jamesbates/jcpu/schematics/control_logic.pdf

# CLK

+5V

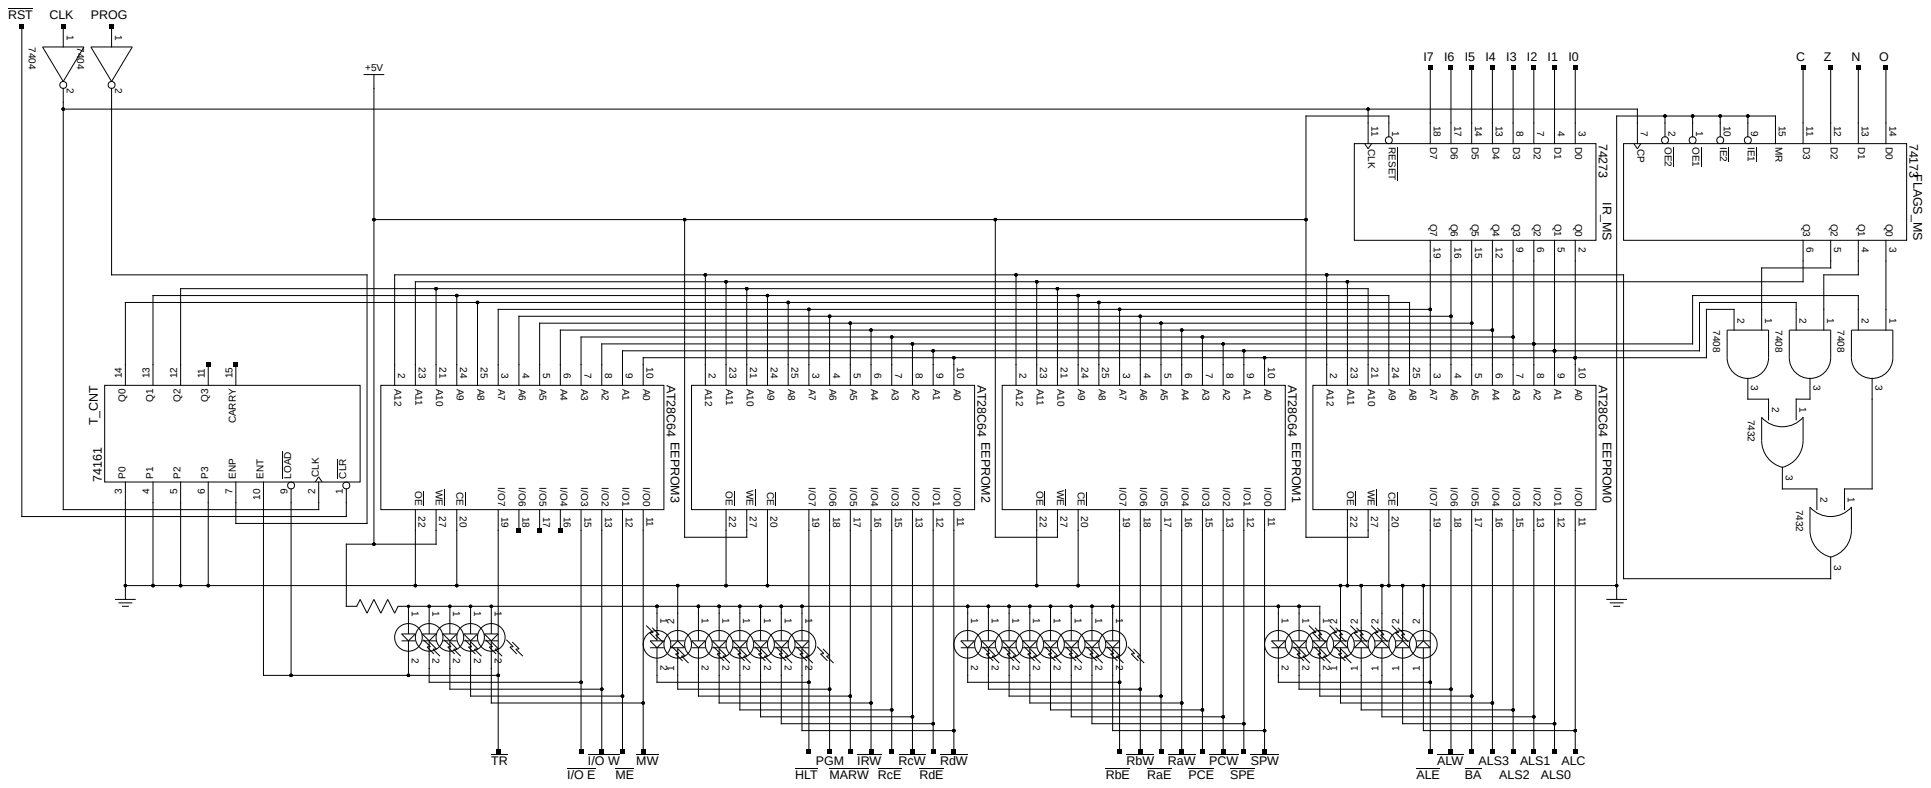
[picture p2: page 1]
