jamesbates/jcpu/schematics/IO.pdf

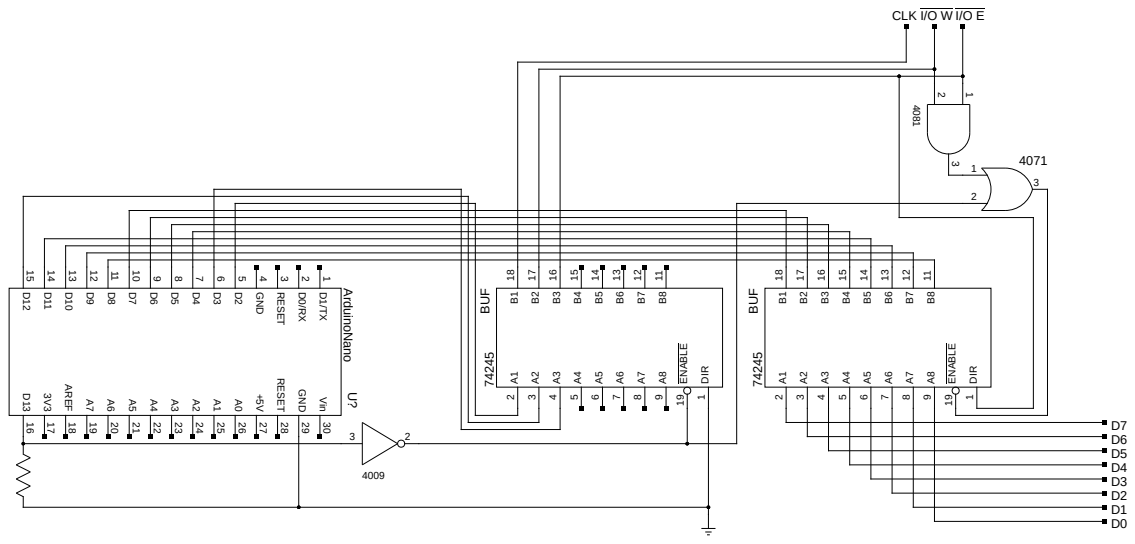
[picture p3: page 1]
