jamesbates/jcpu/schematics/Arduino_programmer.pdf

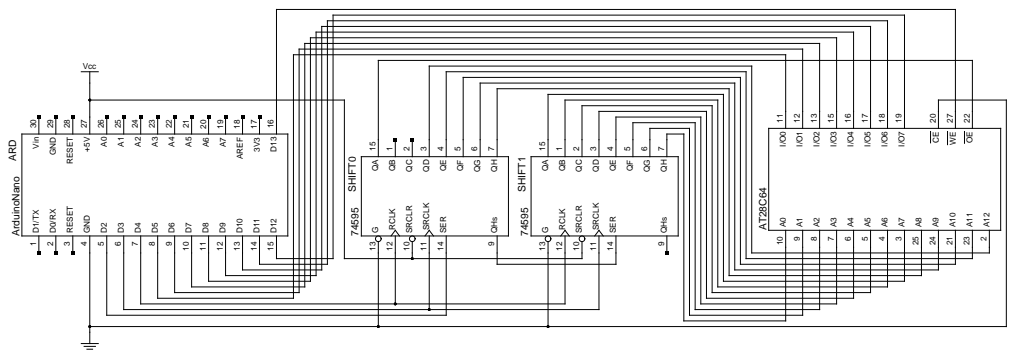
[picture p4: page 1]
