jamesbates/jcpu/schematics/decimal_display.pdf

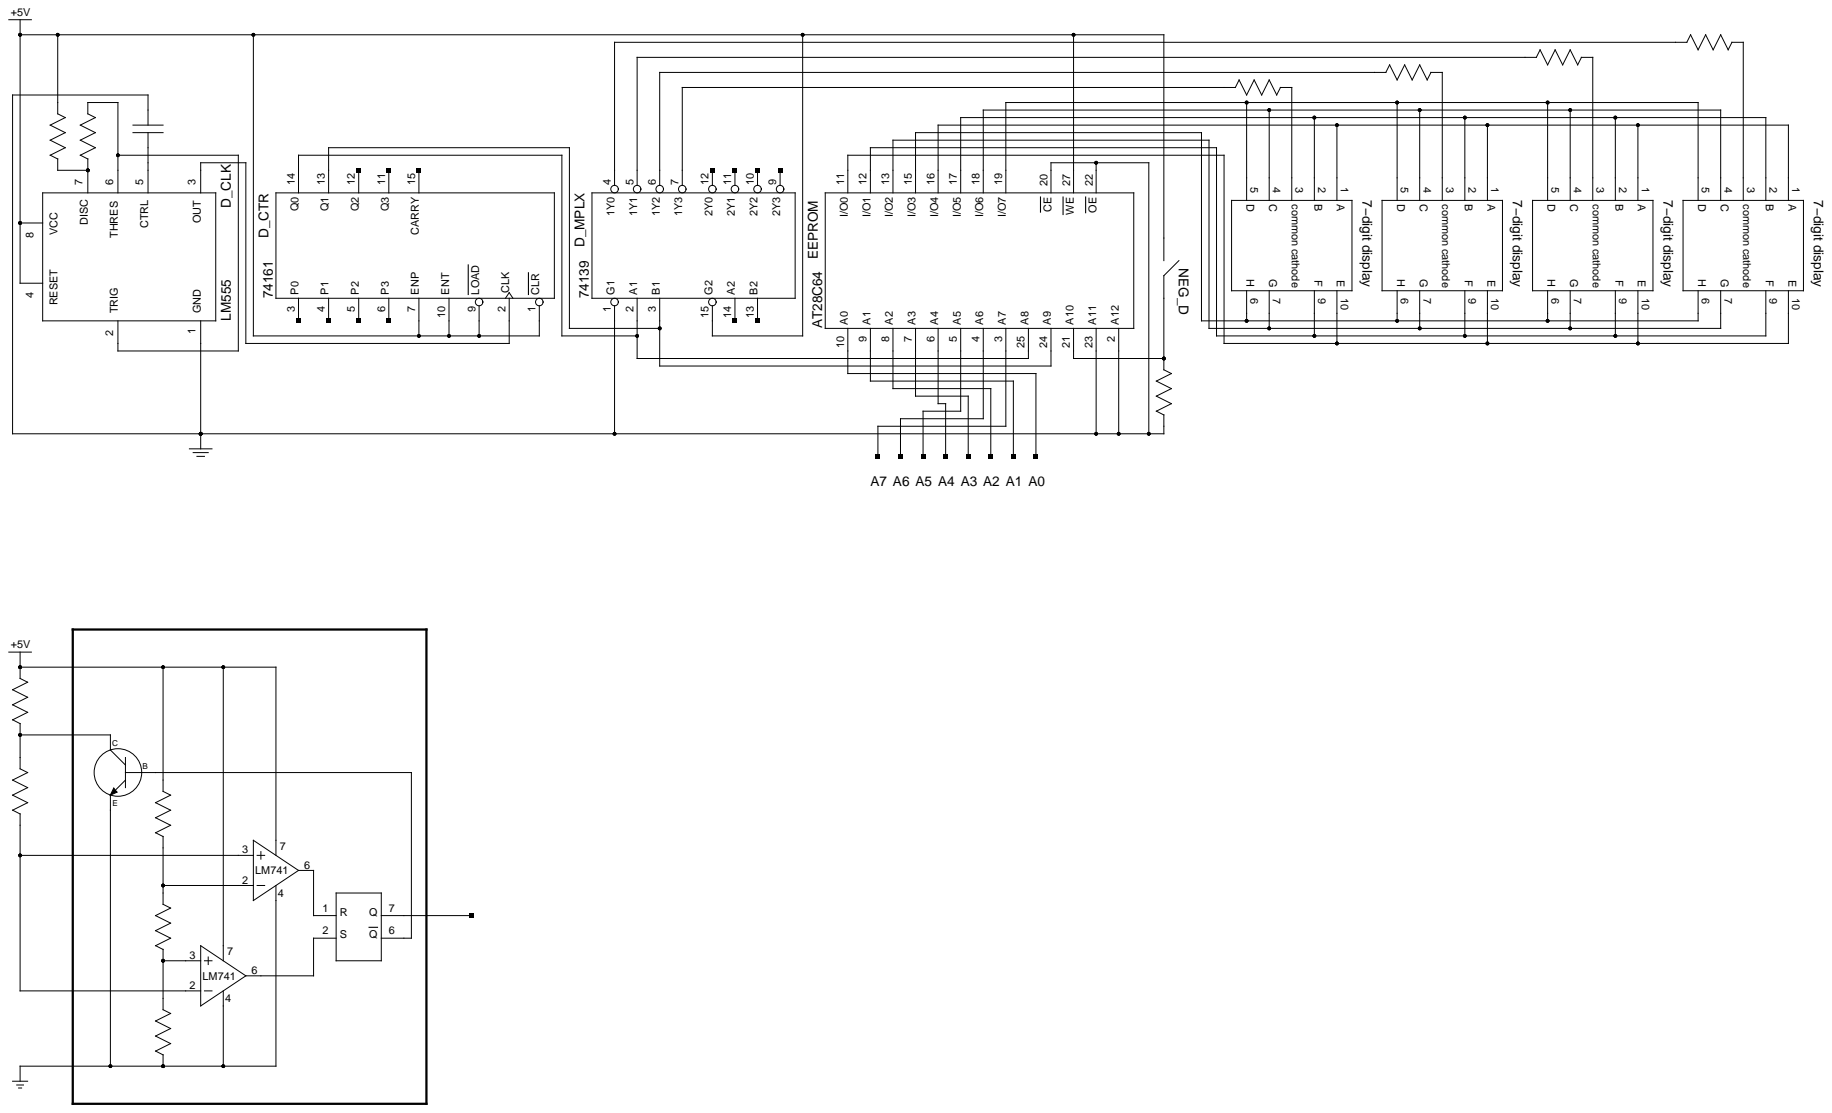
[picture p5: page 1]
