jamesbates/jcpu/schematics/ALU.pdf

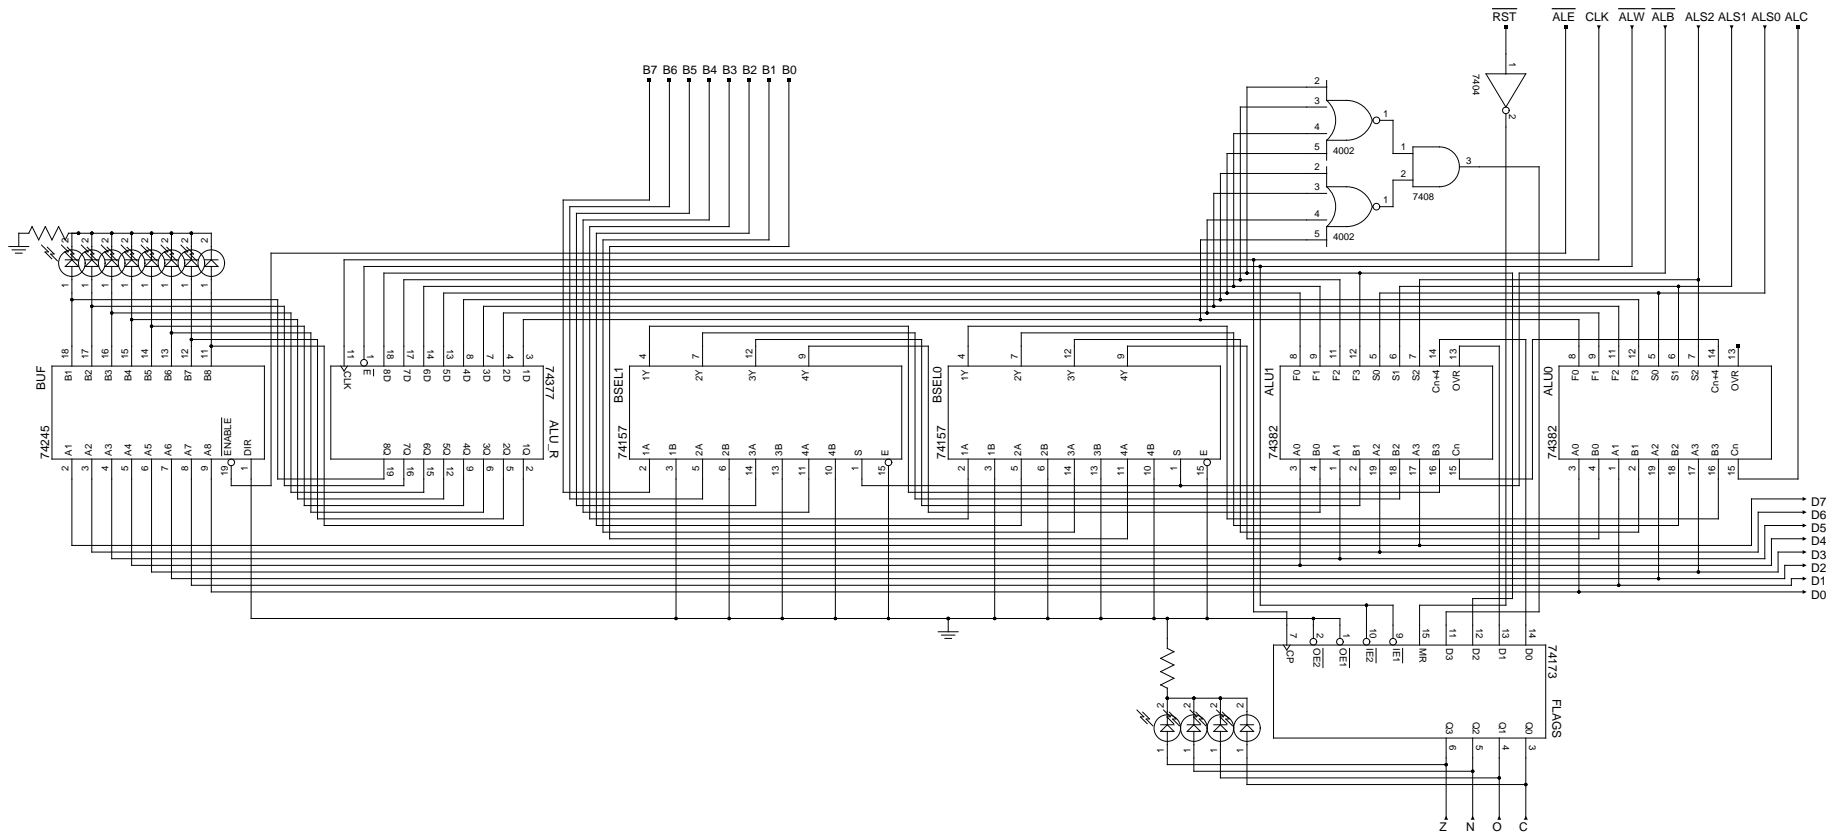
[picture p6: page 1]
