jamesbates/jcpu/schematics/RAM.pdf

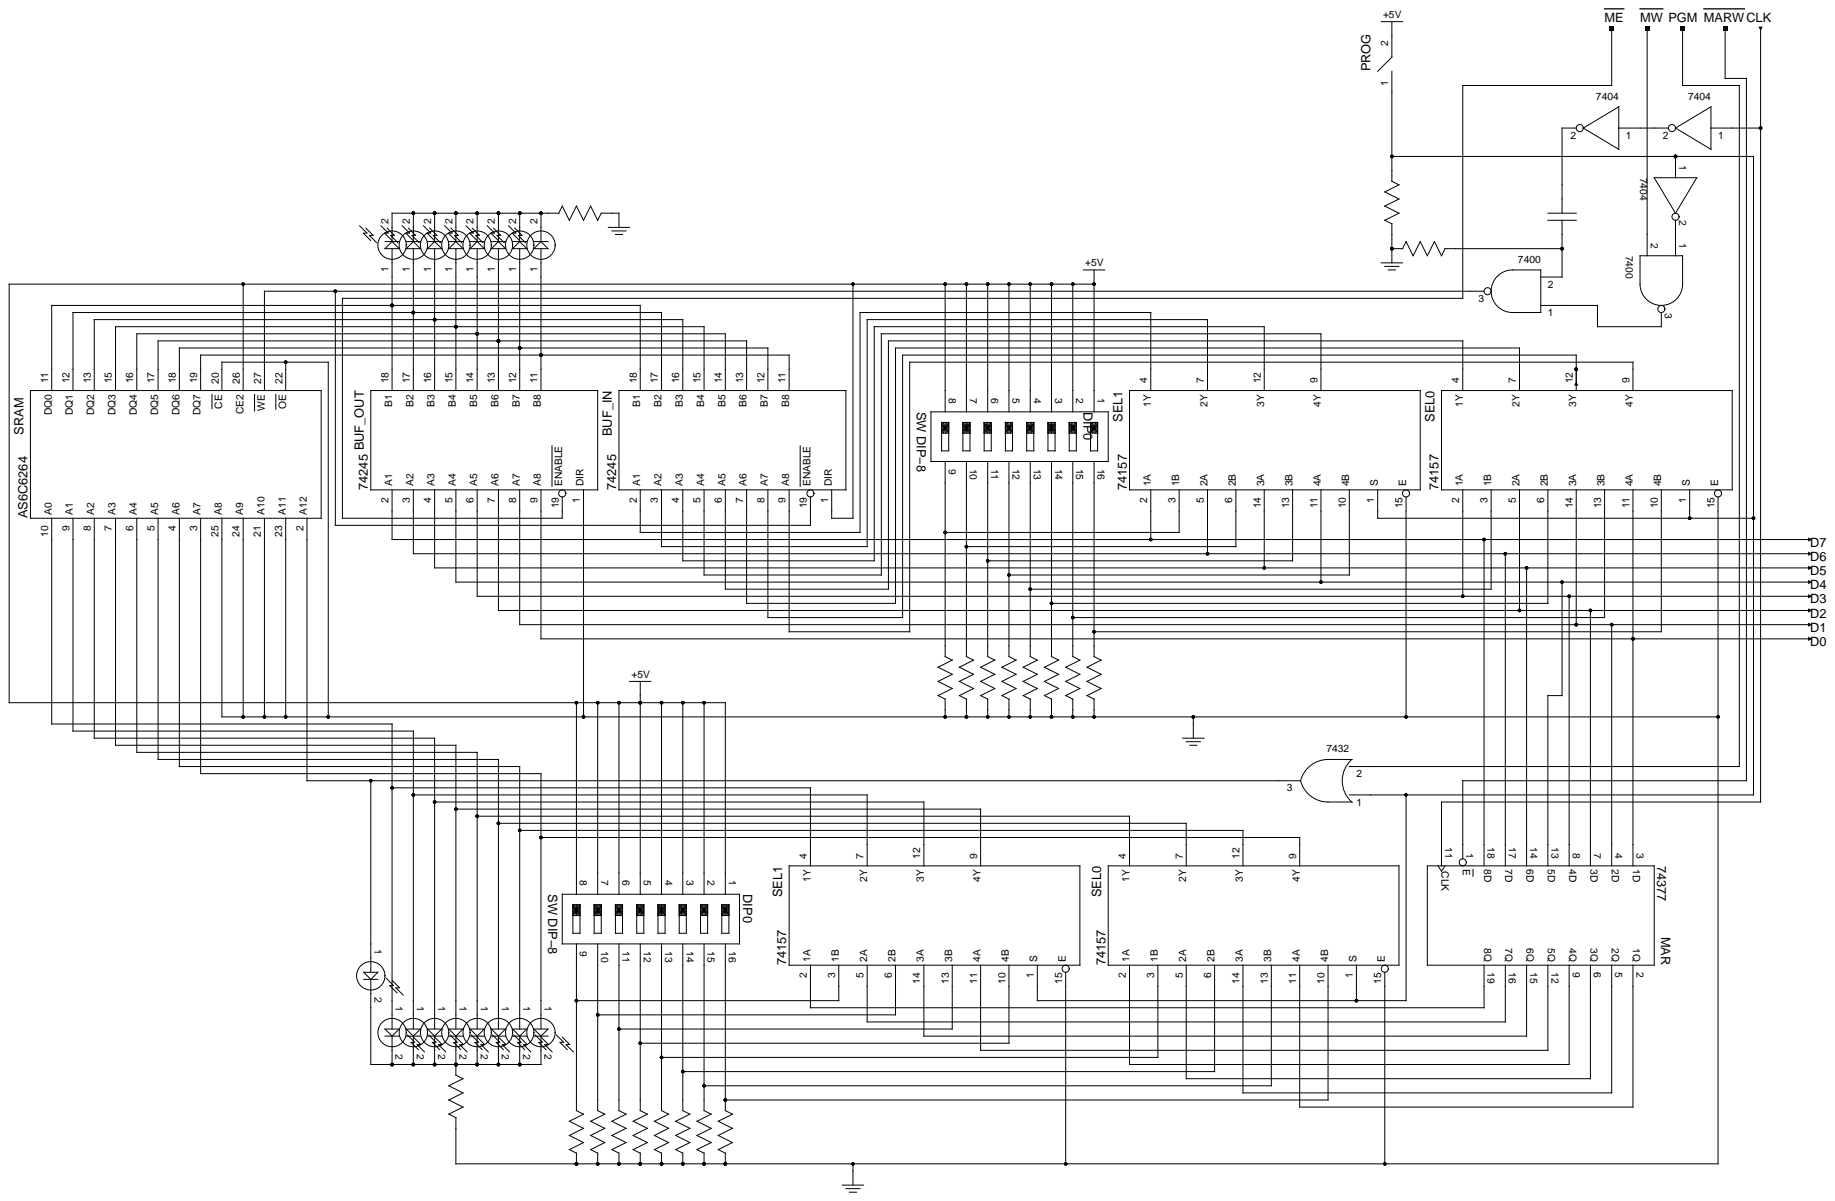
[picture p7: page 1]
