jamesbates/jcpu/schematics/instruction_register.pdf

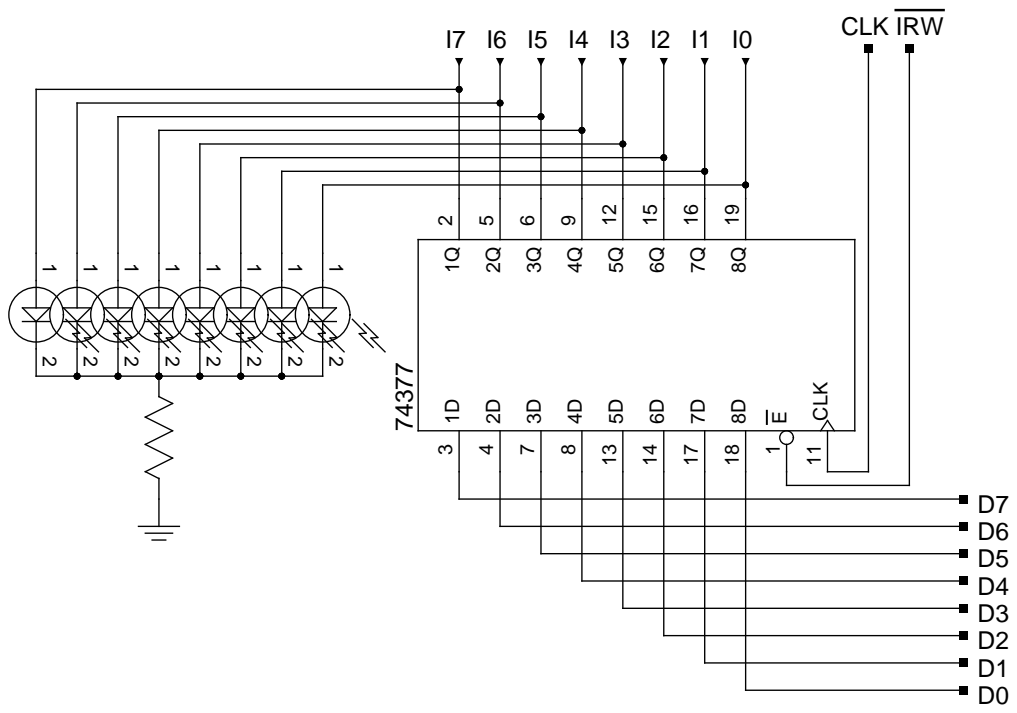
[picture p8: page 1]
