jamesbates/jcpu/schematics/clock.pdf

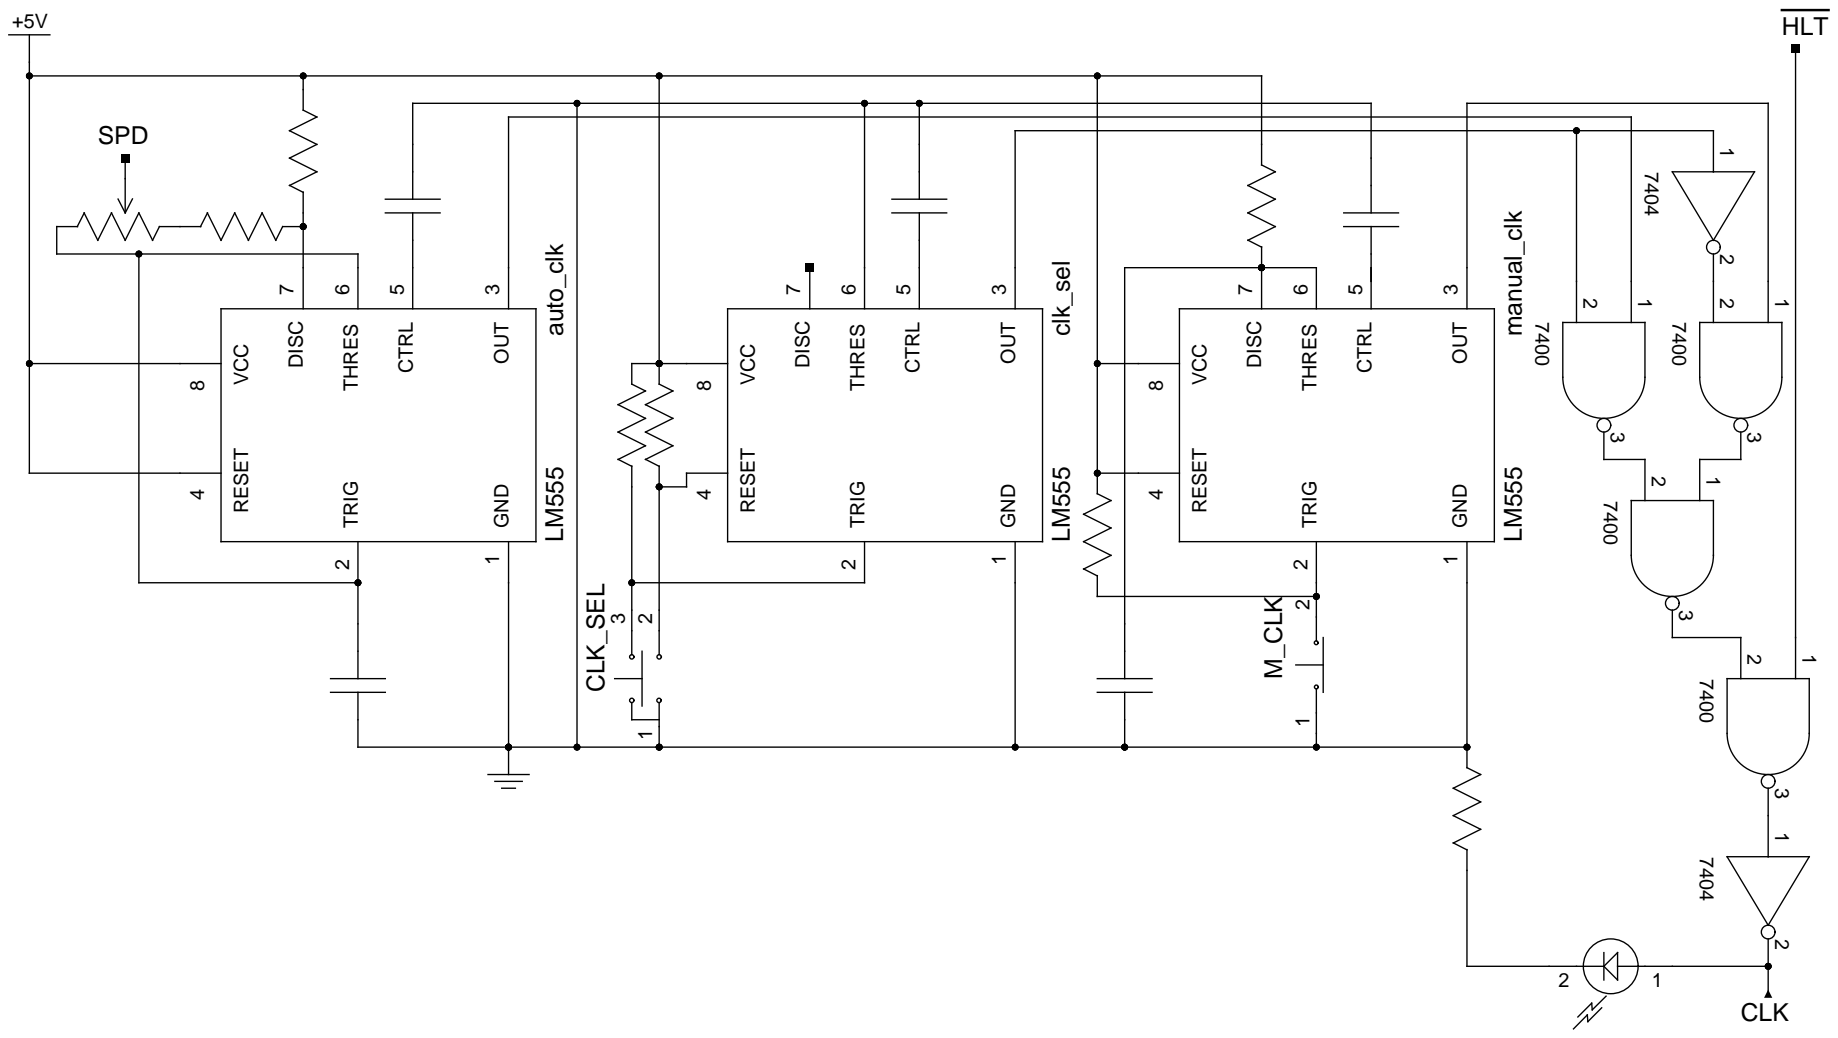
[picture p9: page 1]
RESET VCC; LM555 auto_clk; LM555 manual_clk; LM555 clk_sel
