jamesbates/jcpu/schematics/power.pdf

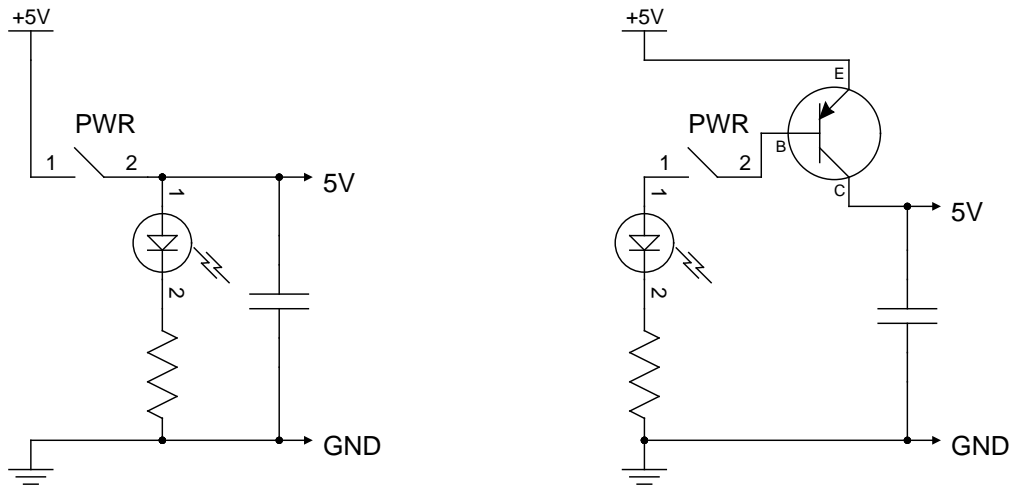
[picture p10: page 1]
