jamesbates/jcpu/schematics/program_counter.pdf

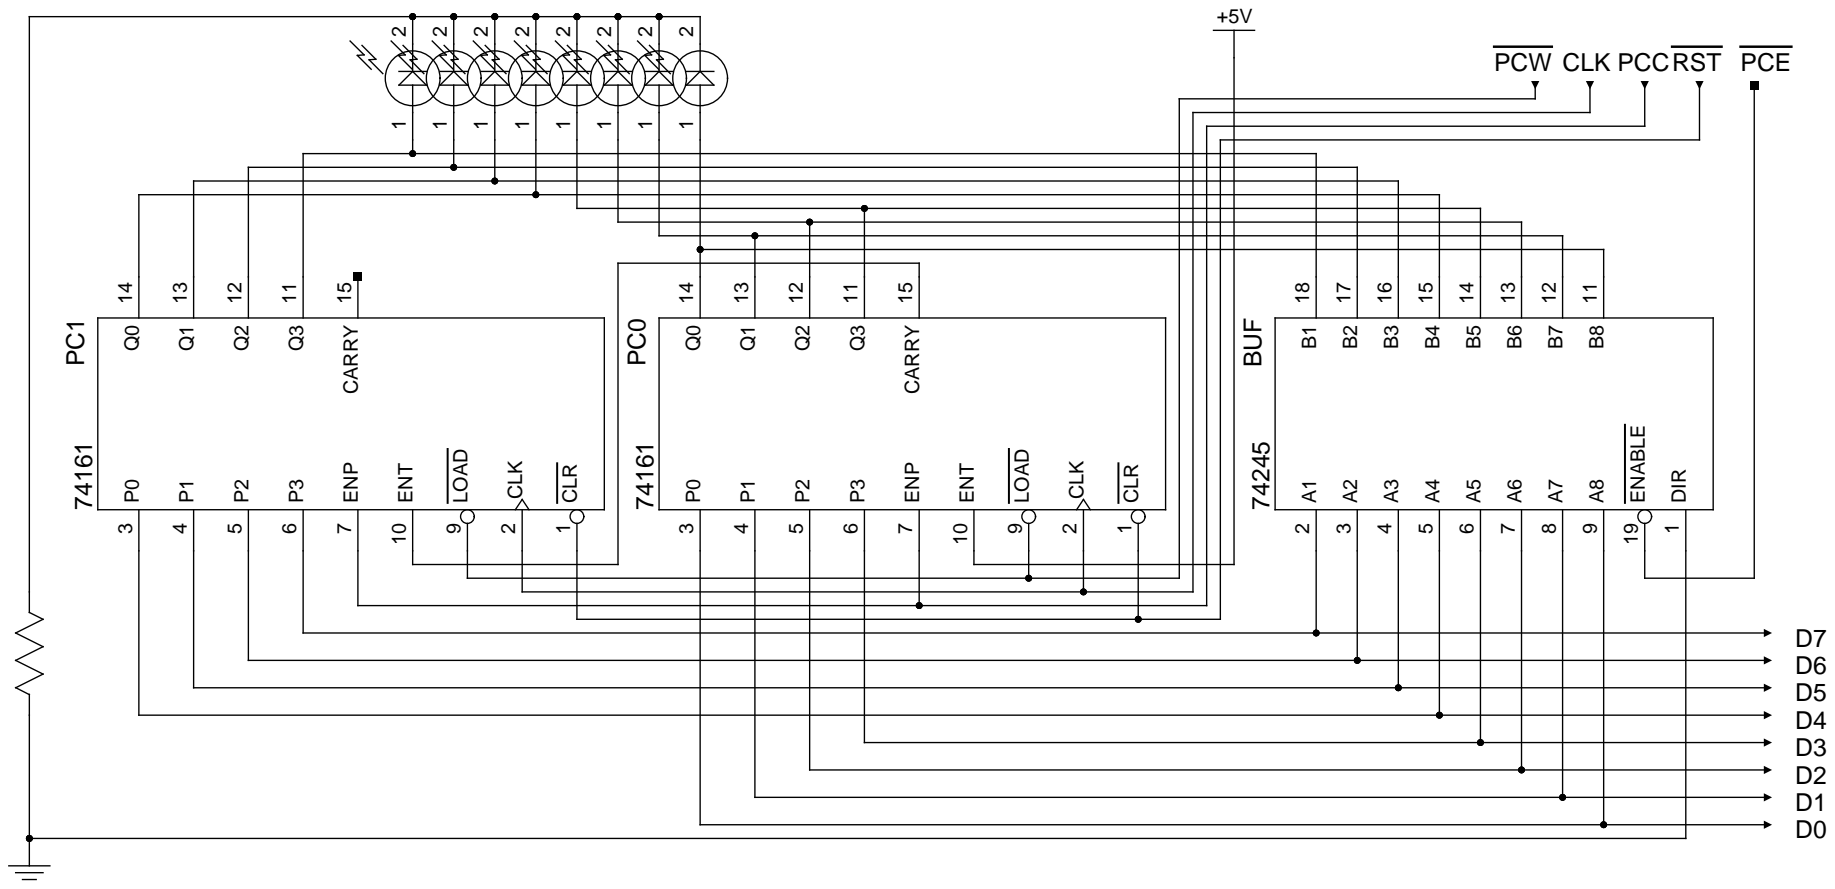
[picture p11: page 1]
