jamesbates/jcpu/schematics/register.pdf

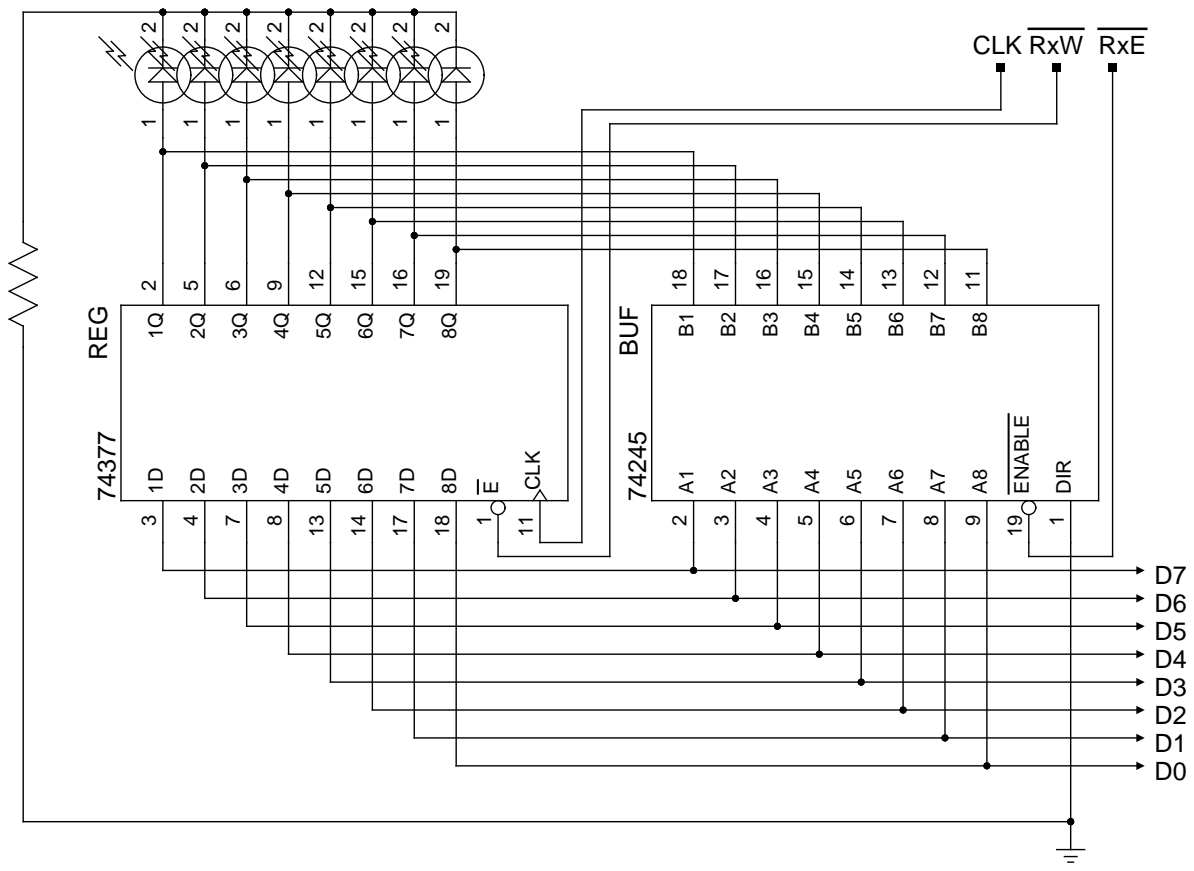
[picture p12: page 1]
