jamesbates/jcpu/arduino/load_pgm/pgm.h

byte pgm[] = {
    0b00000000,   // length byte
    /* 000 */ 0b00000000, 0b00100111, //		DATA SP, #0
    /* 001 */ 0b00000001, 0b00000000,
    /* 002 */ 0b00000010, 0b10111100, //		STO [#prime_count], SP
    /* 003 */ 0b00000011, 0b00000000,
    /* 004 */ 0b00000100, 0b10110111, //		CALL #main
    /* 005 */ 0b00000101, 0b10100000,
    /* 006 */ 0b00000110, 0b00101101, //		HLT
    /* 032 */ 0b00100000, 0b11111011, //	calc_remaind:	CMP Rd, Rb
    /* 033 */ 0b00100001, 0b00111000, //		JC #_1
    /* 034 */ 0b00100010, 0b00100100,
    /* 035 */ 0b00100011, 0b01101110, //		RET
    /* 036 */ 0b00100100, 0b11001011, //	_1:	SUB Rd, Rb
    /* 037 */ 0b00100101, 0b00101111, //		JMP #calc_remaind
    /* 038 */ 0b00100110, 0b00100000,
    /* 064 */ 0b01000000, 0b00001111, //	is_prime:	DATA Rb, #0
    /* 065 */ 0b01000001, 0b00000000,
    /* 066 */ 0b01000010, 0b01010111, //	_5:	LOD Rc, [#prime_count]
    /* 067 */ 0b01000011, 0b00000000,
    /* 068 */ 0b01000100, 0b11110110, //		CMP Rb, Rc
    /* 069 */ 0b01000101, 0b00111000, //		JC #_2
    /* 070 */ 0b01000110, 0b01100010,
    /* 071 */ 0b01000111, 0b00010111, //		DATA Rc, #primes
    /* 072 */ 0b01001000, 0b00000001,
    /* 073 */ 0b01001001, 0b11001110, //		ADD Rc, Rb
    /* 074 */ 0b01001010, 0b01010010, //		LOD Rc, [Rc]
    /* 075 */ 0b01001011, 0b10110001, //		PUSH Rb
    /* 076 */ 0b01001100, 0b00001111, //		DATA Rb, #16
    /* 077 */ 0b01001101, 0b00010000,
    /* 078 */ 0b01001110, 0b11111010, //		CMP Rc, Rb
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
    /* 155 */ 0b10011011, 0b01101110, //	_7:	RET
    /* 160 */ 0b10100000, 0b00000111, //	main:	DATA Ra, #2
    /* 161 */ 0b10100001, 0b00000010,
    /* 162 */ 0b10100010, 0b10110111, //		CALL #find_primes
    /* 163 */ 0b10100011, 0b10000000,
    /* 164 */ 0b10100100, 0b01101110 //		RET
};
