jamesbates/jcpu/(commit log)

2017-09-22 assembler assembles code
2017-09-22 assembler rename
2017-09-23 new progs; assembler fix for 1-letter labels
2017-09-25 assembler operand checking
2017-09-27 schematic tweaks
    [control_logic.sch, instruction_register.sch]
2017-09-30 PROG signal to control logic
    [control_logic.sch]
2017-10-02 RAM schematic fix
    [RAM.sch]
2017-10-14 ALU update
    [ALU.sch]
2017-10-24 misc fixes
    [Arduino_programmer.sch, decimal_display.sch]
2017-11-26 arduino code tweaks
2026-10-07 CPU I/O upgrades: assembler + load/dump programs
2026-10-07 instruction step clock
    [clock_step.sch]
2026-10-13 schematics update + new sample programs
